menshen-tsai/aprs_ground_station/README.md

# APRS Ground Station Hardware and Firmware/Software for Hand-On Class
