menshen-tsai/aprs_ground_station/Ground_Station_SR105U_20251230/Ground_Station_SR105U_20251230.pdf

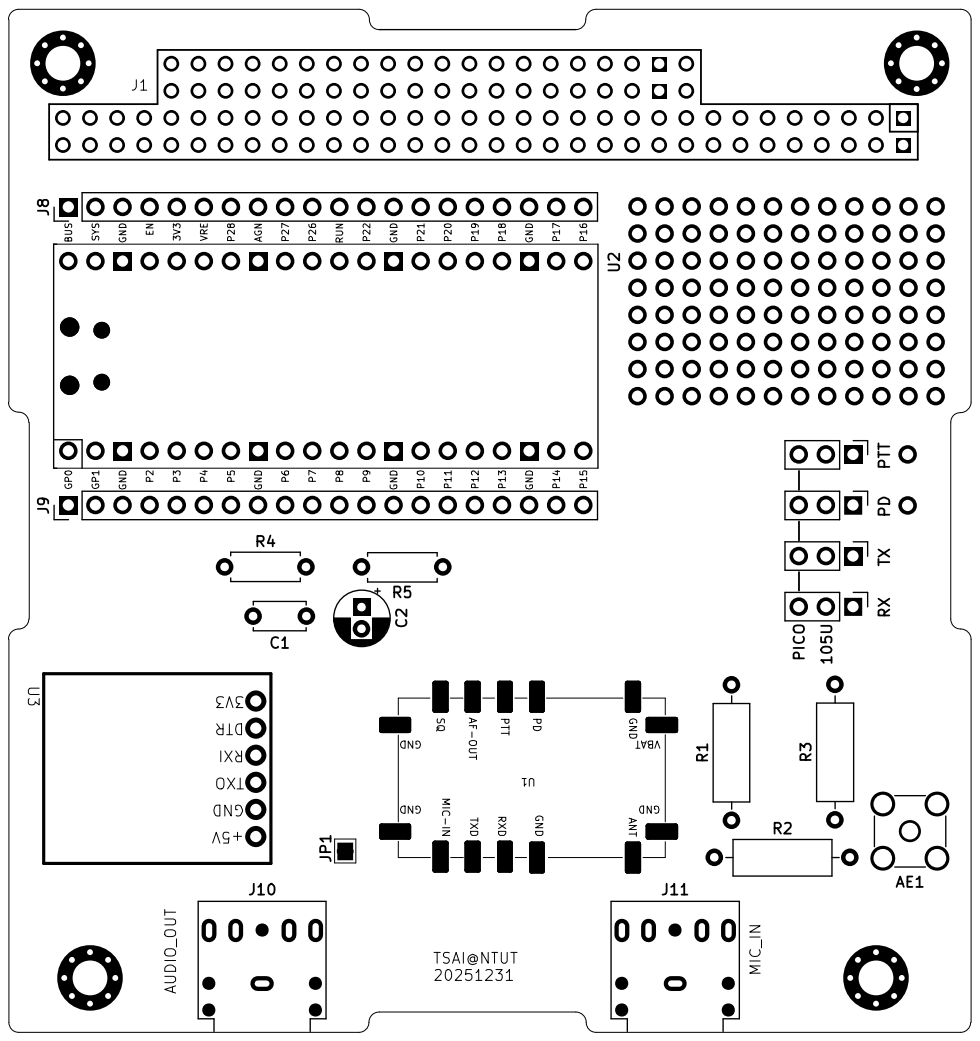
[picture p1: page 1]
