menshen-tsai/aprs_ground_station/Ground_Station_SR105U_20260104_ATTEN_SMD/Ground_Station_SR105U_20260104_ATTEN_SMD.kicad_pcb

## KiCad design Ground_Station_SR105U_20260104_ATTEN_SMD/Ground_Station_SR105U_20260104_ATTEN_SMD.kicad_pcb (2026-02-05)

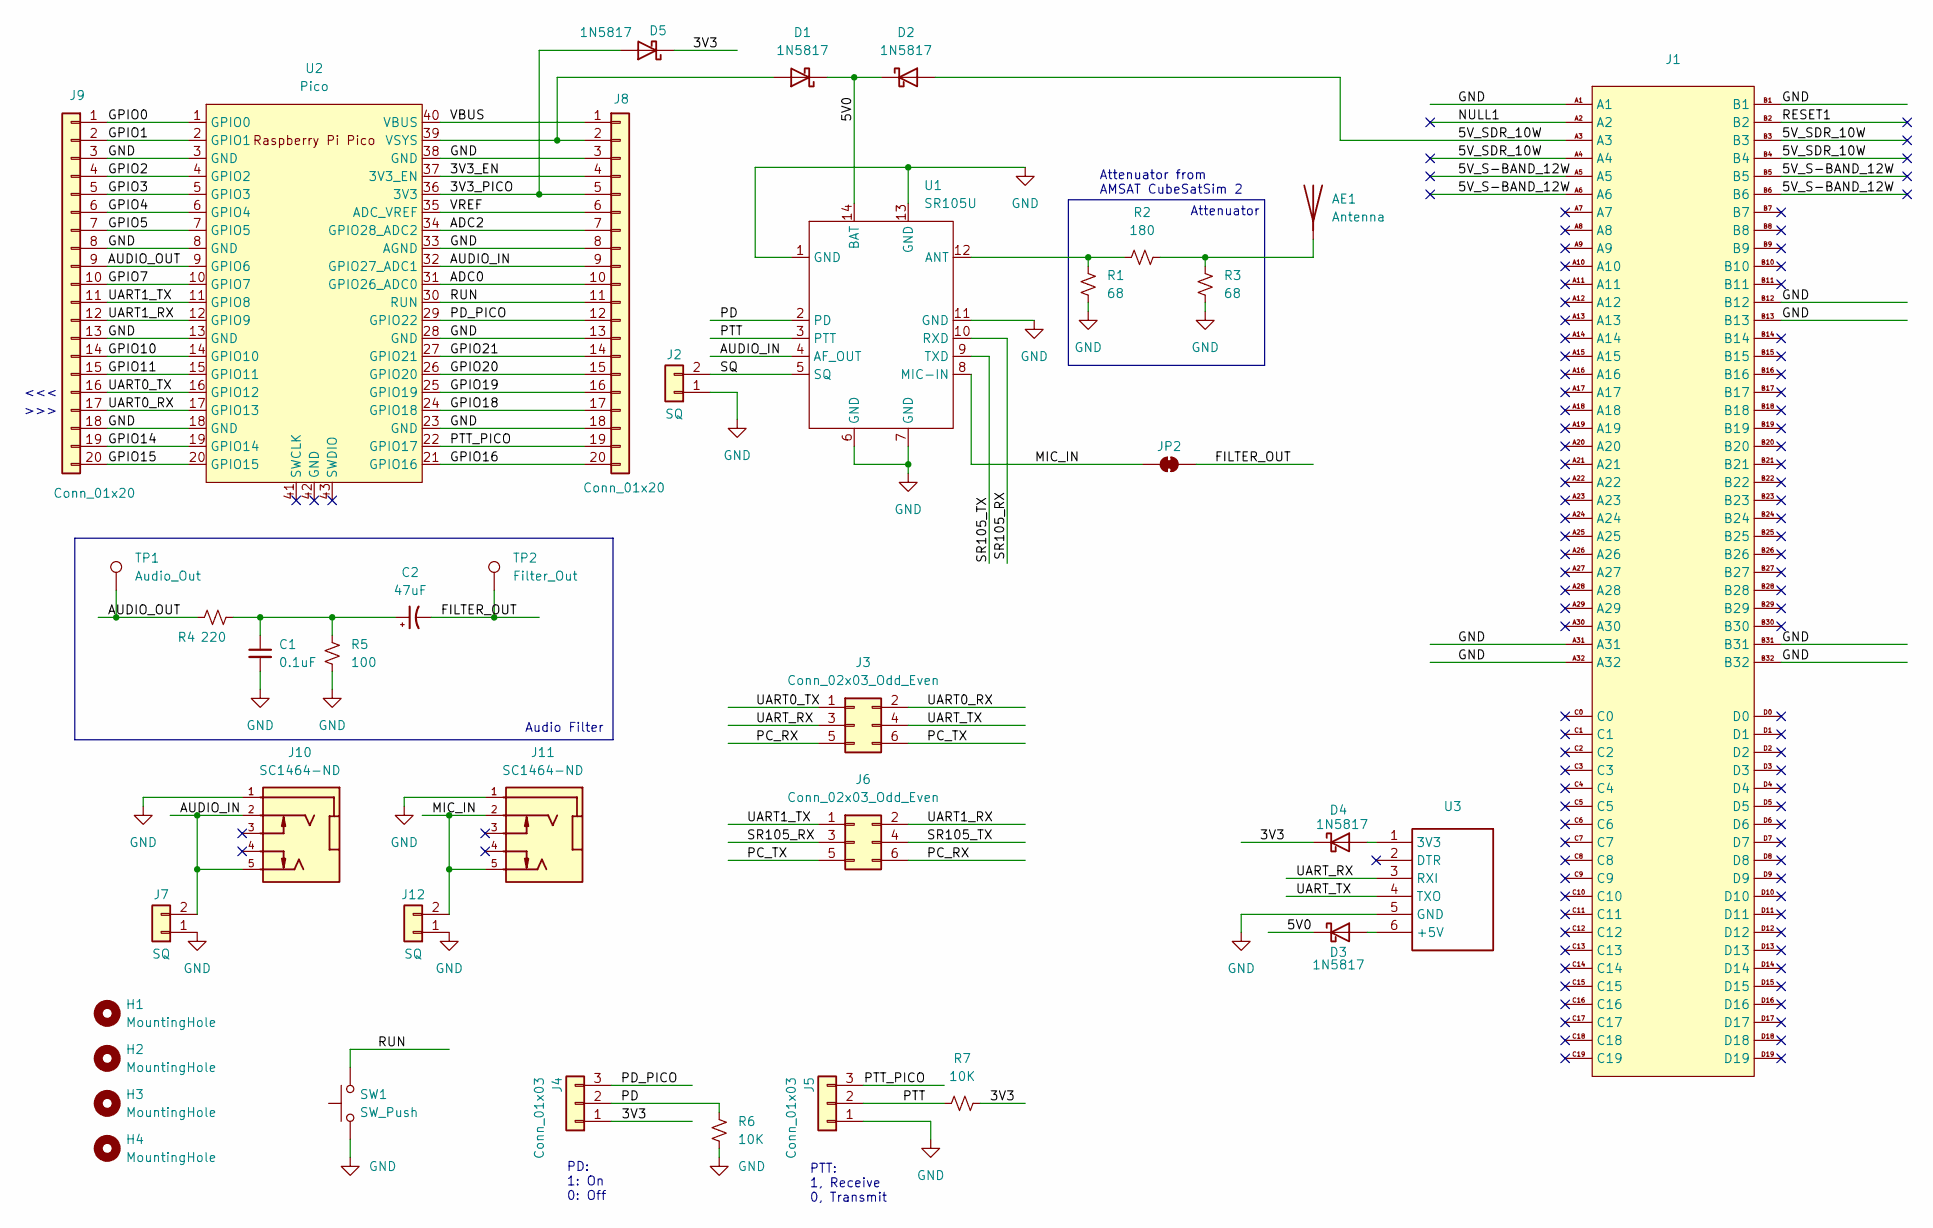
[picture p2: schematic Ground_Station_SR105U_20260104_ATTEN_SMD.kicad_sch]

Parts:
AE1: Antenna; SMA_Amphenol_901-144_Vertical
C1: 0.1uF; C_Disc_D4.7mm_W2.5mm_P5.00mm
C2: 47uF; CP_Radial_D5.0mm_P2.00mm
D1, D2, D3: 1N5817; D_DO-41_SOD81_P10.16mm_Horizontal
D4, D5: 1N5817; Diode_TH
H1, H2, H3, H4: MountingHole; MountingHole_3.2mm_M3_Pad_Via
J1: PC104_16bit_Connector
J2, J7, J12: SQ; PinHeader_1x02_P2.54mm_Vertical
J3, J6: Conn_02x03_Odd_Even; PinHeader_2x03_P2.54mm_Vertical
J4, J5: Conn_01x03; PinHeader_1x03_P2.54mm_Vertical
J8, J9: Conn_01x20; PinHeader_1x20_P2.54mm_Vertical
J10, J11: SC1464-ND; Jack_3.5mm_CUI_SJ1-3525N_Horizontal
JP2: SolderJumper_2_Bridged; SolderJumper-2_P1.3mm_Bridged_Pad1.0x1.5mm
R1, R3: 68; R_1206_3216Metric
R2: 180; R_1206_3216Metric
R4: 220; R_Axial_DIN0207_L6.3mm_D2.5mm_P7.62mm_Horizontal
R5: 100; R_Axial_DIN0207_L6.3mm_D2.5mm_P7.62mm_Horizontal
R6, R7: 10K; R_Axial_DIN0207_L6.3mm_D2.5mm_P7.62mm_Horizontal
SW1: SW_Push; SW_PUSH_1P1T_6x3.5mm_H4.3_APEM_MJTP1243
TP1: Audio_Out; TestPoint_THTPad_D1.5mm_Drill0.7mm
TP2: Filter_Out; TestPoint_THTPad_D1.5mm_Drill0.7mm
U1: SR105U
U2: Pico; RPi_Pico_TH
U3: USB_UART_Module_New

Connections:
/3V3: D4.1 (K), D5.1 (K), J4.1, R7.1
/3V3_EN: J8.4, U2.37 (3V3_EN)
/3V3_PICO: D5.2 (A), J8.5, U2.36 (3V3)
/5V0: D1.1 (K), D2.1 (K), D3.1 (K), U1.14 (BAT)
/5V_S-BAND_12W: J1.A5, J1.A6, J1.B5, J1.B6
/5V_SDR_10W: D2.2 (A), J1.A3, J1.A4, J1.B3, J1.B4
/ADC0: J8.10, U2.31 (GPIO26_ADC0)
/ADC2: J8.7, U2.34 (GPIO28_ADC2)
/AUDIO_IN: J7.2, J8.9, J10.2, J10.5, U1.4 (AF_OUT), U2.32 (GPIO27_ADC1)
/AUDIO_OUT: J9.9, R4.1, TP1.1, U2.9 (GPIO6)
/FILTER_OUT: C2.2, JP2.2 (B), TP2.1
/GPIO0: J9.1, U2.1 (GPIO0)
/GPIO1: J9.2, U2.2 (GPIO1)
/GPIO2: J9.4, U2.4 (GPIO2)
/GPIO3: J9.5, U2.5 (GPIO3)
/GPIO4: J9.6, U2.6 (GPIO4)
/GPIO5: J9.7, U2.7 (GPIO5)
/GPIO7: J9.10, U2.10 (GPIO7)
/GPIO10: J9.14, U2.14 (GPIO10)
/GPIO11: J9.15, U2.15 (GPIO11)
/GPIO14: J9.19, U2.19 (GPIO14)
/GPIO15: J9.20, U2.20 (GPIO15)
/GPIO16: J8.20, U2.21 (GPIO16)
/GPIO18: J8.17, U2.24 (GPIO18)
/GPIO19: J8.16, U2.25 (GPIO19)
/GPIO20: J8.15, U2.26 (GPIO20)
/GPIO21: J8.14, U2.27 (GPIO21)
/MIC_IN: J11.2, J11.5, J12.2, JP2.1 (A), U1.8 (MIC-IN)
/NULL1: J1.A2
/PC_RX: J3.5, J6.6
/PC_TX: J3.6, J6.5
/PD: J4.2, R6.2, U1.2 (PD)
/PD_PICO: J4.3, J8.12, U2.29 (GPIO22)
/PTT: J5.2, R7.2, U1.3 (PTT)
/PTT_PICO: J5.3, J8.19, U2.22 (GPIO17)
/RESET1: J1.B2
/RUN: J8.11, SW1.2, U2.30 (RUN)
/SQ: J2.2, U1.5 (SQ)
/SR105_RX: J6.3, U1.10 (RXD)
/SR105_TX: J6.4, U1.9 (TXD)
/UART0_RX: J3.2, J9.17, U2.17 (GPIO13)
/UART0_TX: J3.1, J9.16, U2.16 (GPIO12)
/UART1_RX: J6.2, J9.12, U2.12 (GPIO9)
/UART1_TX: J6.1, J9.11, U2.11 (GPIO8)
/UART_RX: J3.3, U3.3 (RXI)
/UART_TX: J3.4, U3.4 (TXO)
/VBUS: J8.1, U2.40 (VBUS)
/VREF: J8.6, U2.35 (ADC_VREF)
GND: C1.2, J1.A1, J1.A31, J1.A32, J1.B1, J1.B12, J1.B13, J1.B31, J1.B32, J2.1, J5.1, J7.1, J8.3, J8.8, J8.13, J8.18, J9.3, J9.8, J9.13, J9.18, J10.1, J11.1, J12.1, R1.2, R3.2, R5.1, R6.1, SW1.1, U1.1 (GND), U1.6 (GND), U1.7 (GND), U1.11 (GND), U1.13 (GND), U2.3 (GND), U2.8 (GND), U2.13 (GND), U2.18 (GND), U2.23 (GND), U2.28 (GND), U2.33 (AGND), U2.38 (GND), U3.5 (GND)
unnamed: AE1.1 (A), R2.2, R3.1
unnamed: C1.1, C2.1, R4.2, R5.2
unnamed: D1.2 (A), J8.2, U2.39 (VSYS)
unnamed: D3.2 (A), U3.6 (+5V)
unnamed: D4.2 (A), U3.1 (3V3)
unnamed: R1.1, R2.1, U1.12 (ANT)

Notes on the sheet:
PD: 1: On 0: Off
Attenuator
PTT: 1, Receive 0, Transmit
>>>
<<<
Attenuator from AMSAT CubeSatSim 2
Audio Filter

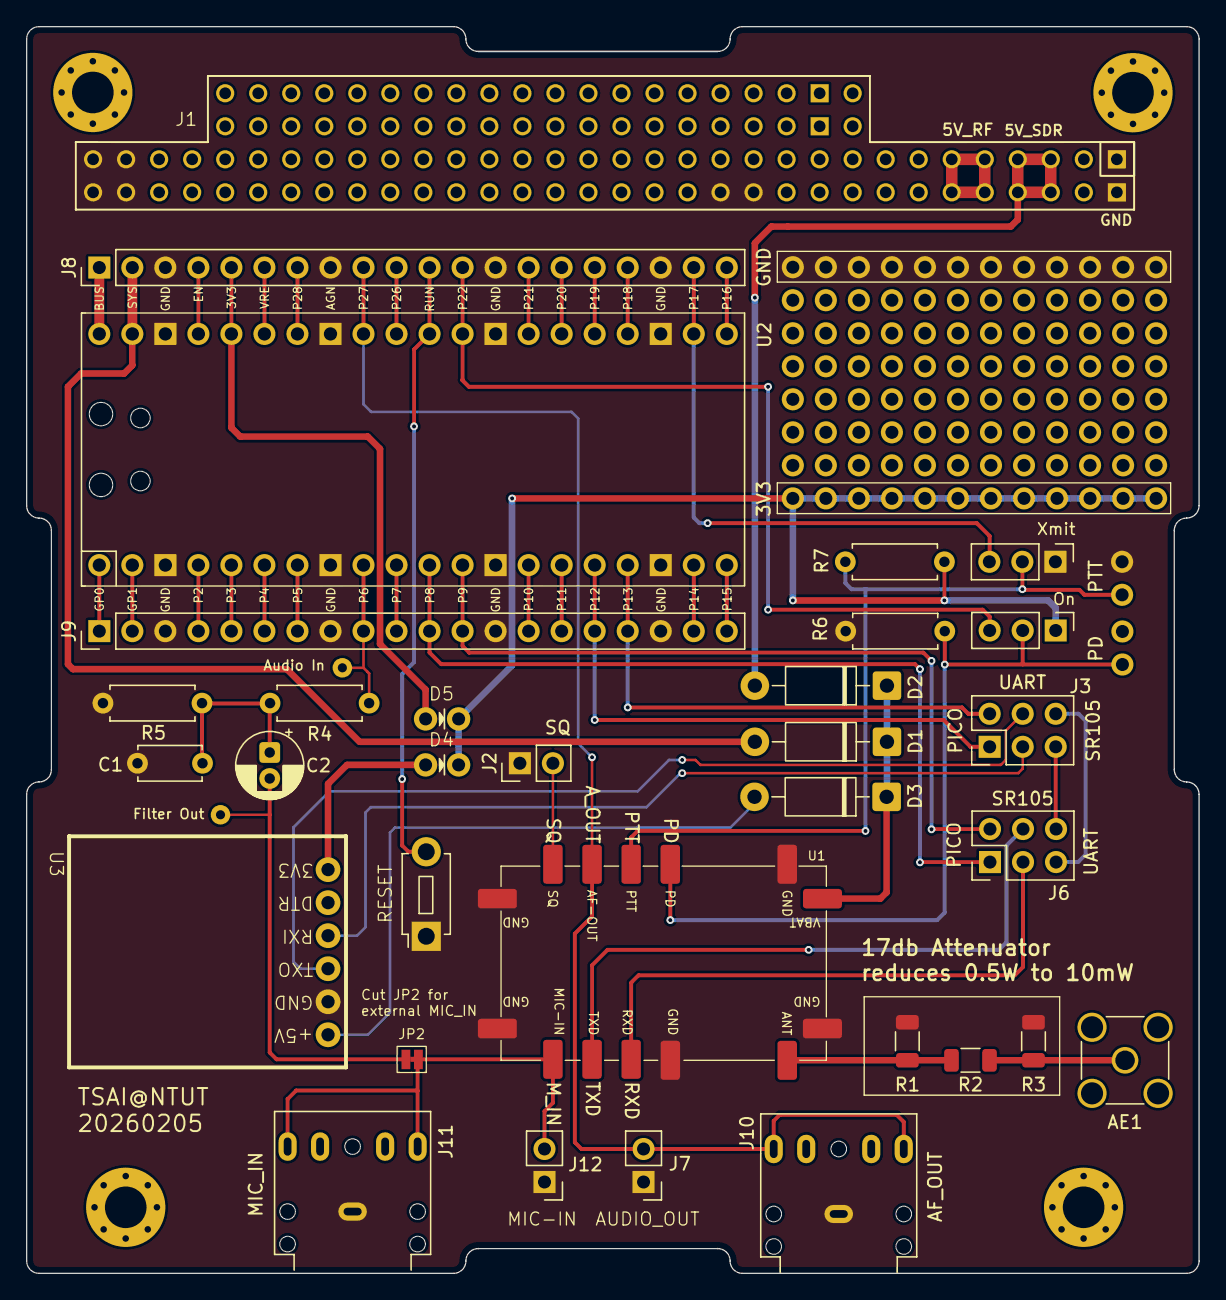
[picture p3: board Ground_Station_SR105U_20260104_ATTEN_SMD.kicad_pcb from above]

Board: 2 copper layers, 90.2 x 95.9 mm, 38 parts (0 on the bottom side), 53 nets.
