menshen-tsai/aprs_ground_station/(commit log)

2026-01-30 Add Kicad design files.
    [Ground_Station_SR105U_20260104_ATTEN_SMD.kicad_pcb, Ground_Station_SR105U_20260104_ATTEN_SMD.kicad_sch, bom.csv, designators.csv, positions.csv]
2026-01-30 Add old Kicad design files. PCB is based on this design.
    [Ground_Station_SR105U_20251230.kicad_pcb, Ground_Station_SR105U_20251230.kicad_sch]
2026-01-30 Add Arduino codes, python code.
2026-01-30 Update APRS_PICO.ppt, add one page to explain bi-directional configuration of the ground station.
2026-02-05 Add test points for audio filter
    [Ground_Station_SR105U_20260104_ATTEN_SMD.kicad_pcb, Ground_Station_SR105U_20260104_ATTEN_SMD.kicad_sch, bom.csv, designators.csv, positions.csv]
